Nourbakhsh-Rad/IRremoteClone/docs/IRremote_Sch.jpg

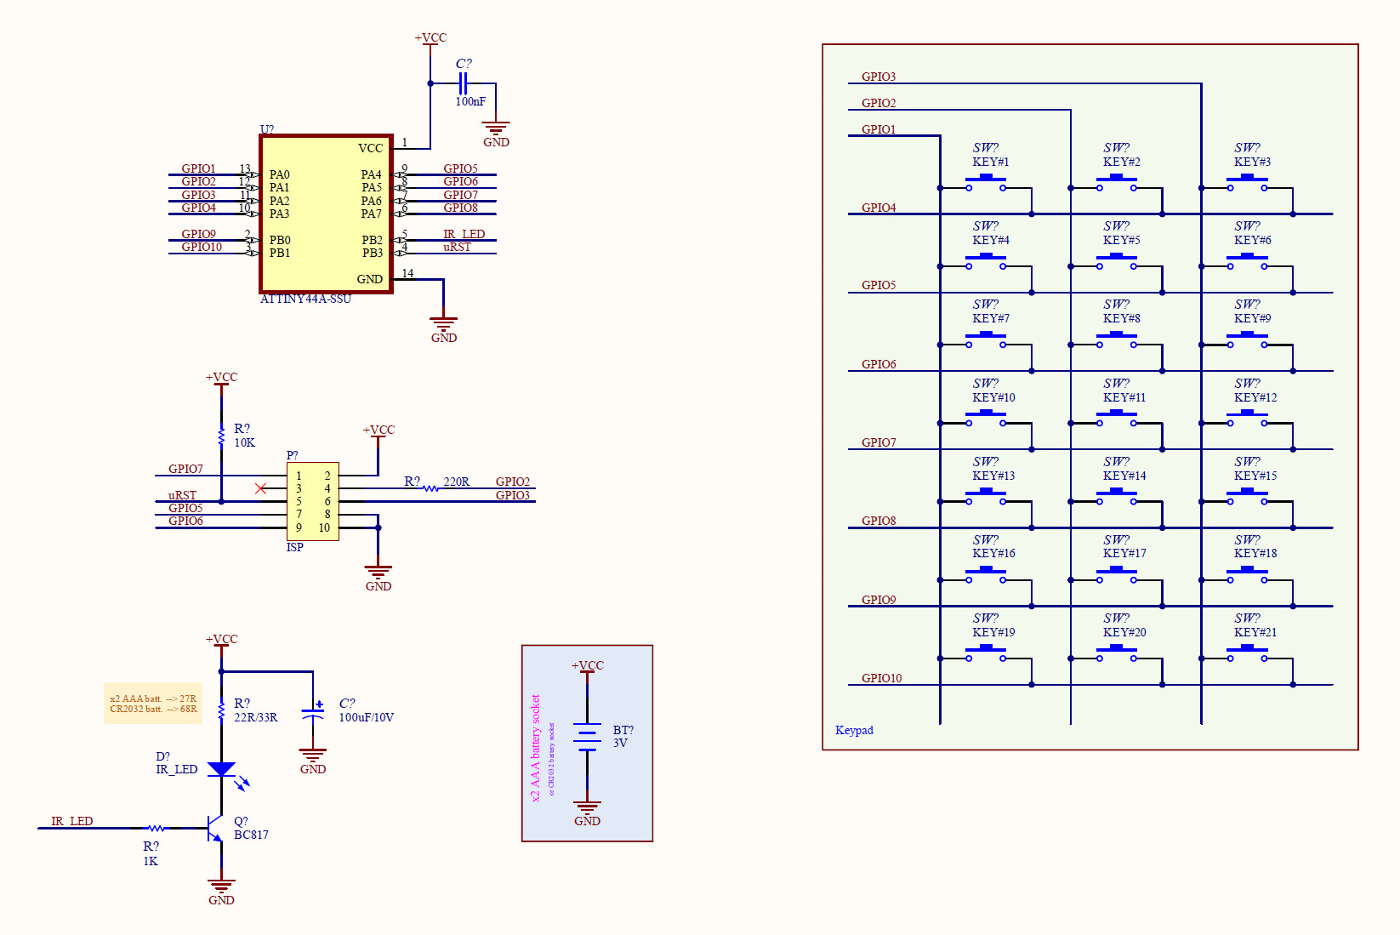
docs/IRremote_Sch.jpg
