Nourbakhsh-Rad/IRremoteClone/docs/IRremote_Sch.pdf

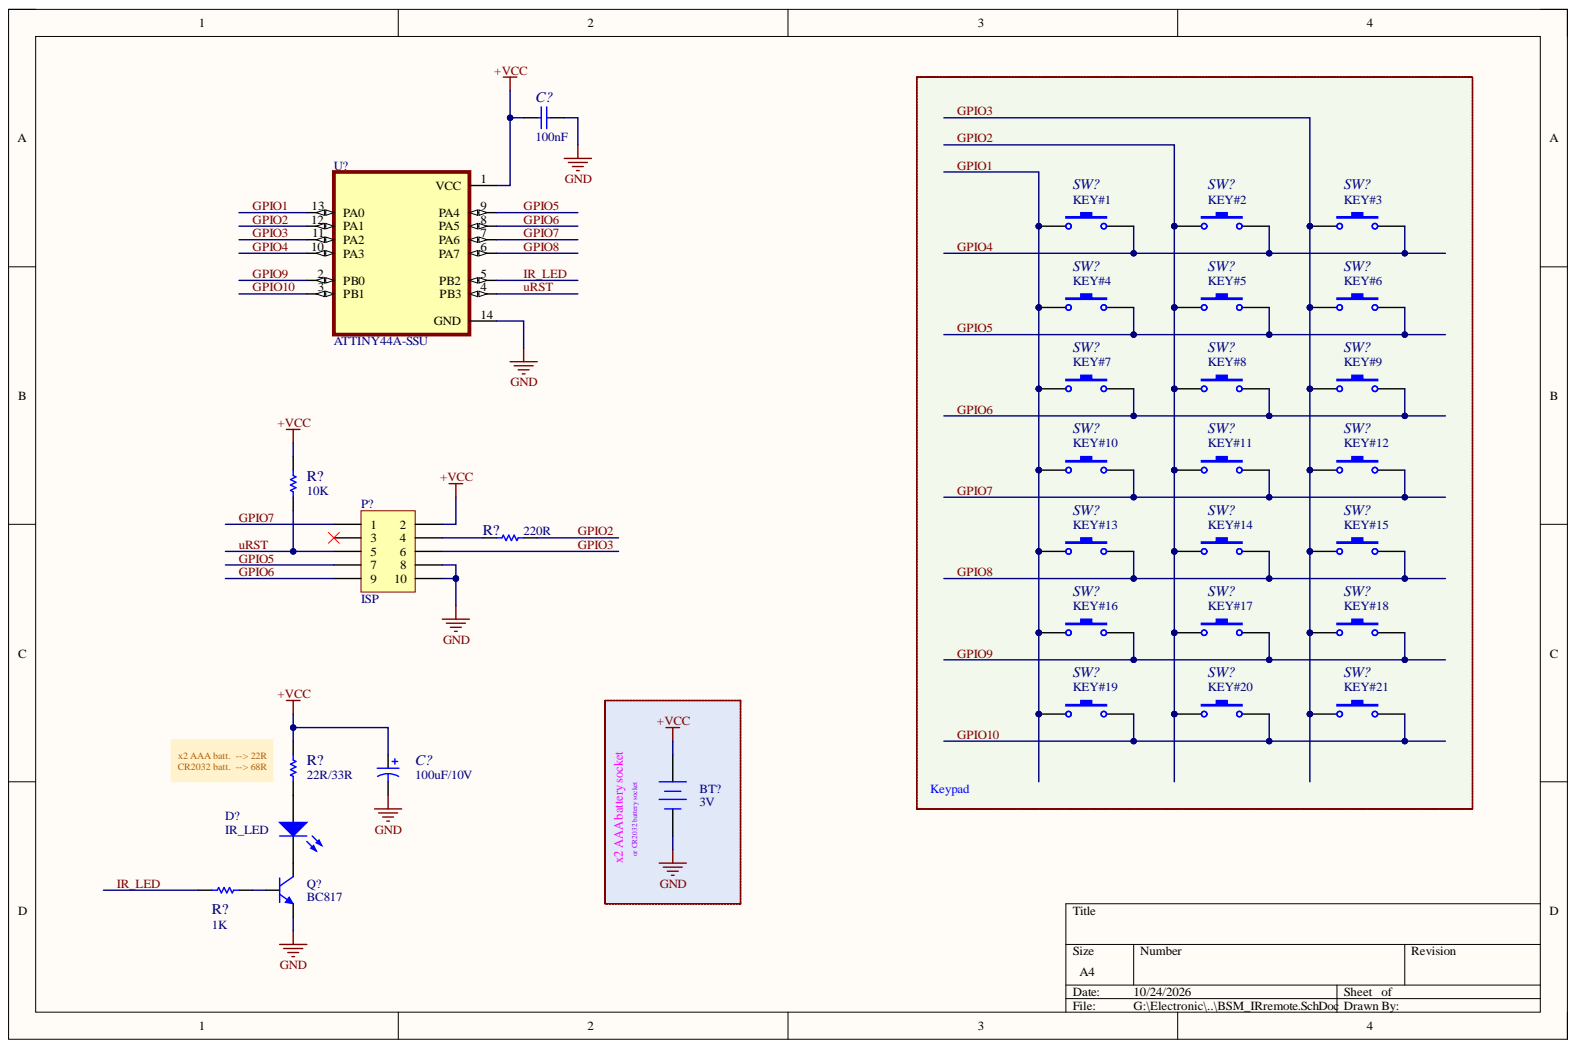
[picture p2: page 1]

Size A4 | Number | Revision

Date: 10/24/2026 | Sheet of
File: G:\Electronic\..\BSM_IRremote.SchDoc Drawn By:
